ls1031/Claude-ESP32-PCB-Demo/hardware/docs/schematic.pdf

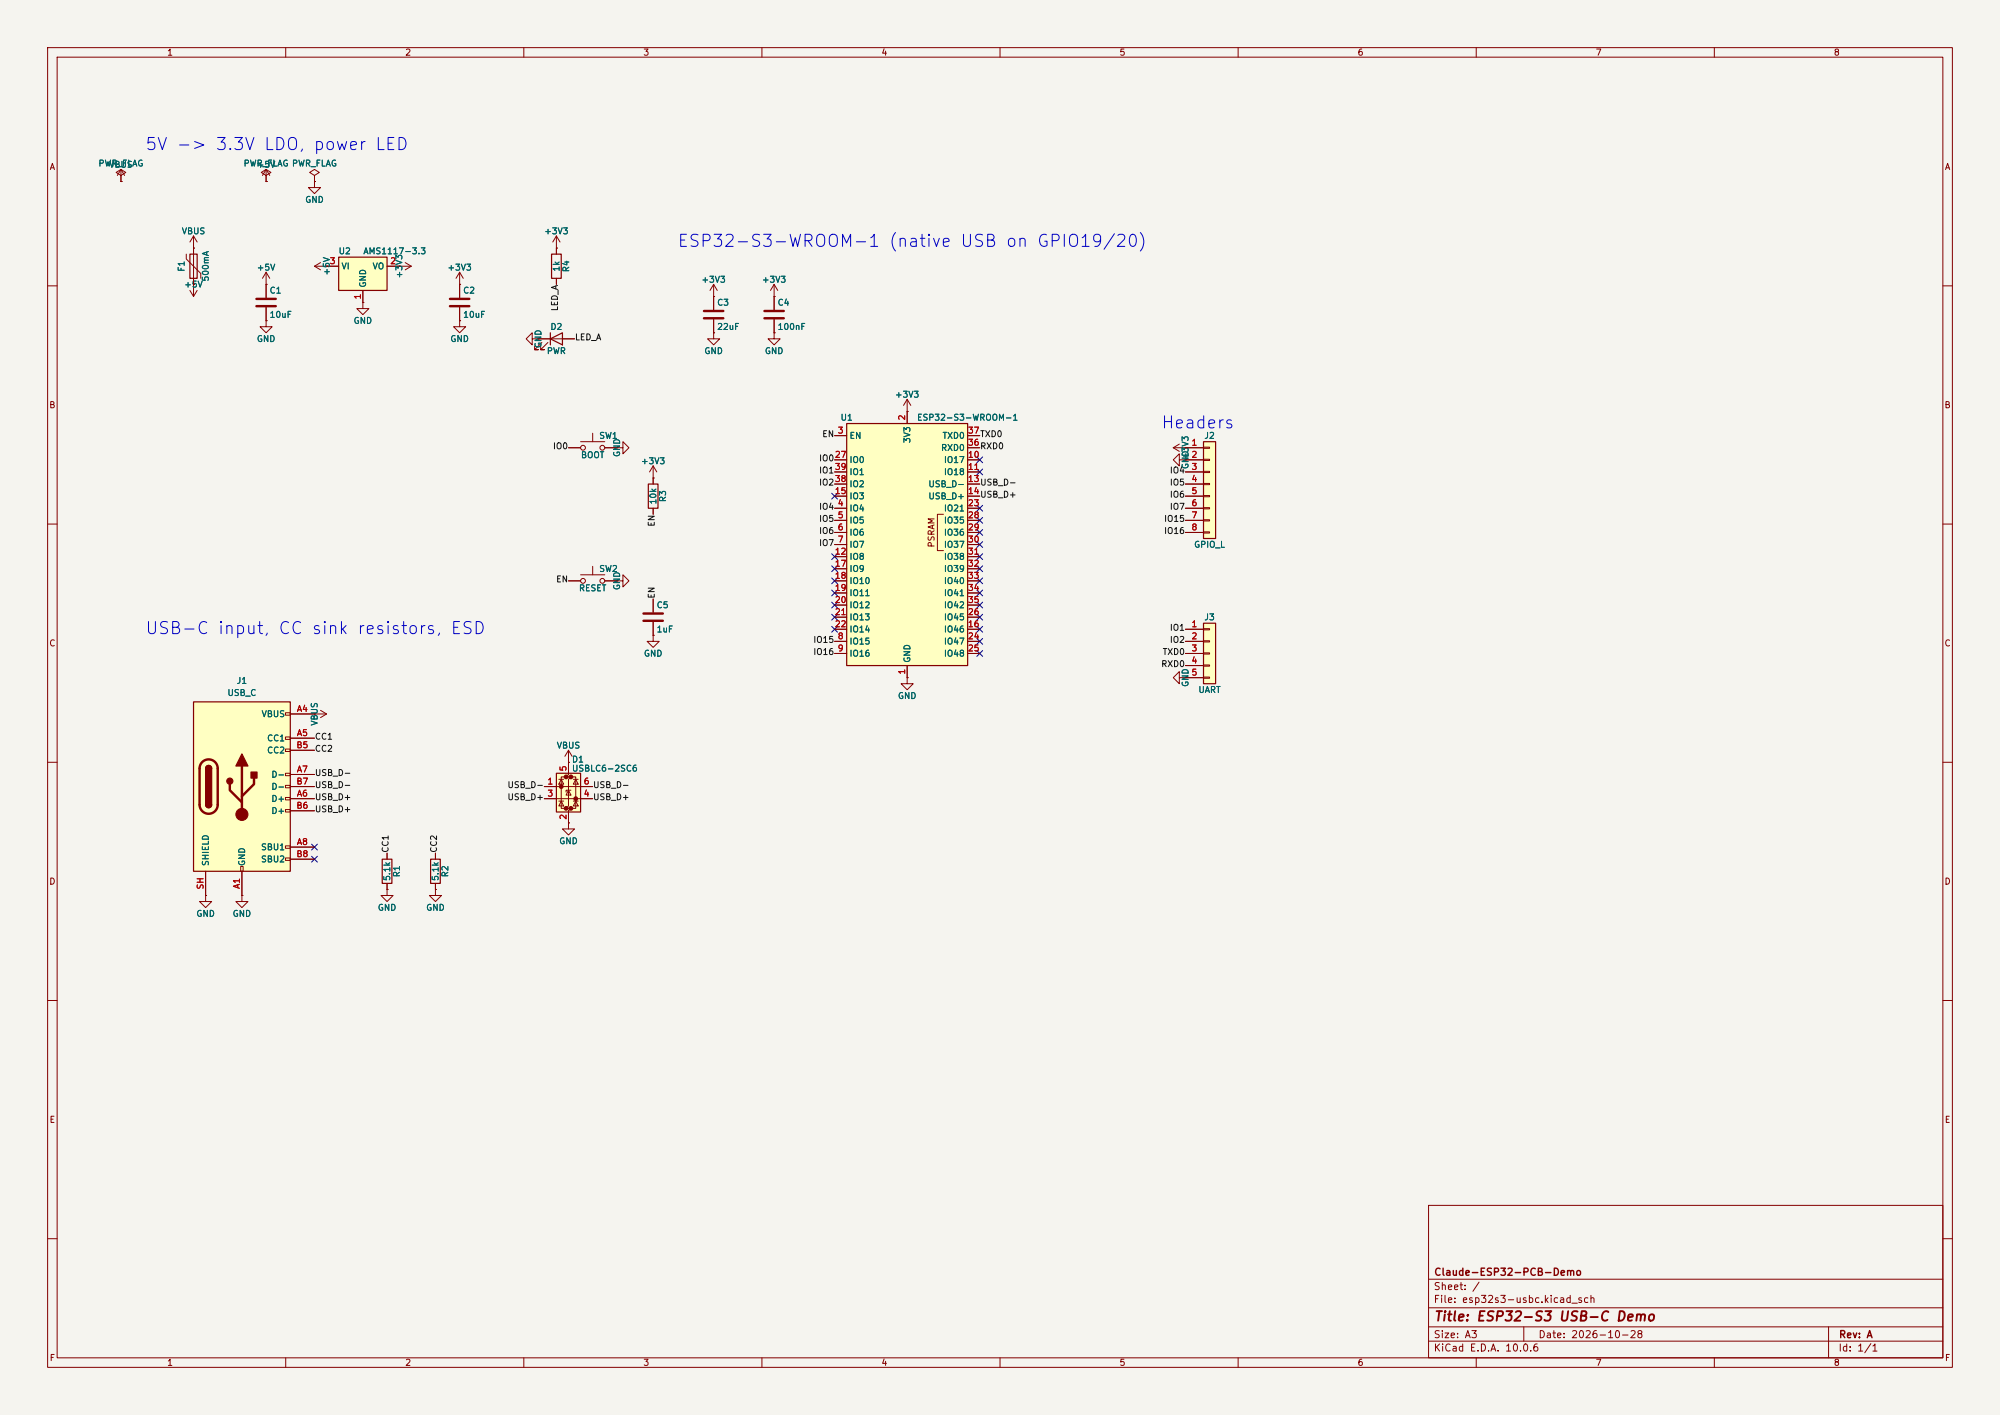
[picture p3: page 1]

ESP32-S3-WROOM-1 (native USB on GPIO19/20)

USB-C input, CC sink resistors, ESD

Size: A3 | Rev: A | F Date: 2026-10-28
KiCad E.D.A. 10.0.6 | Id: 1/1
