ls1031/Claude-ESP32-PCB-Demo/hardware/esp32s3-usbc/esp32s3-usbc.kicad_pcb

## KiCad design hardware/esp32s3-usbc/esp32s3-usbc.kicad_pcb (2026-10-29)

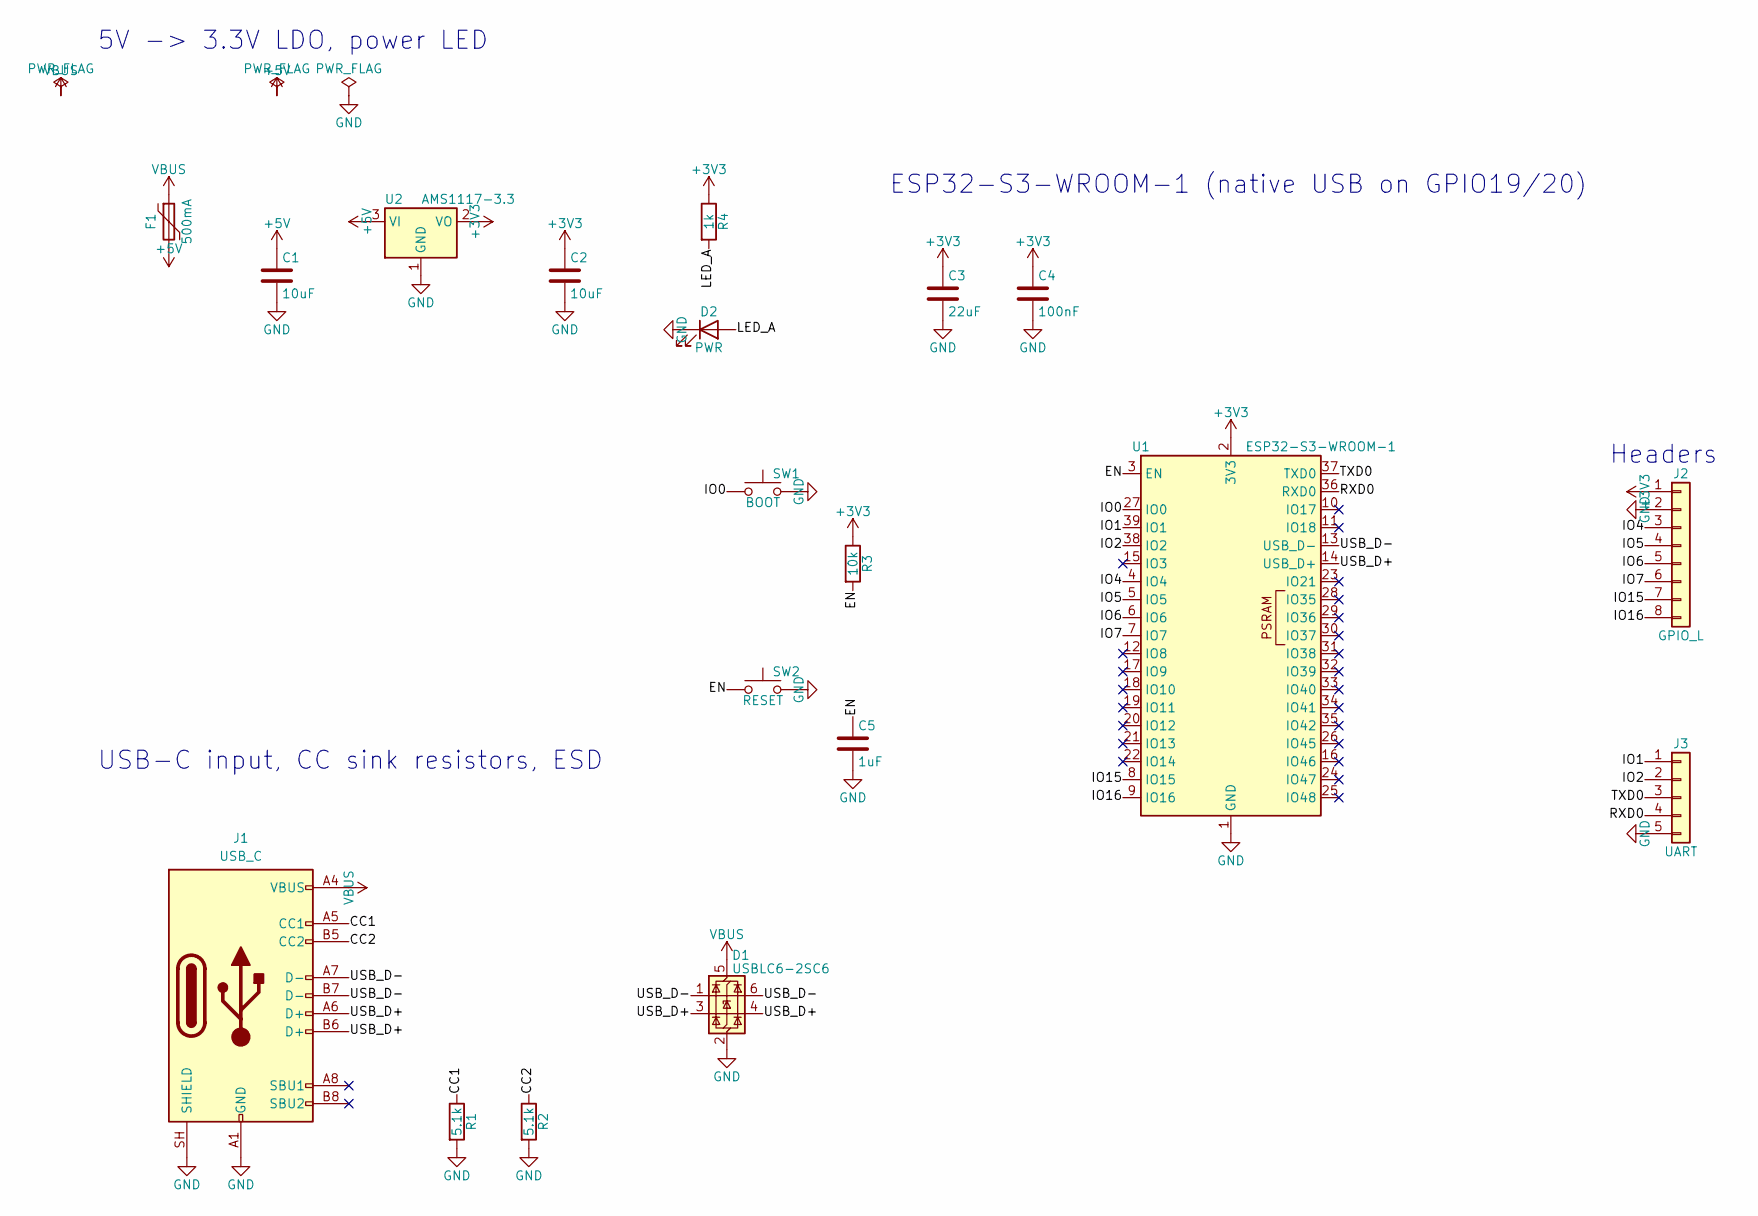
[picture p4: schematic esp32s3-usbc.kicad_sch, ESP32-S3 USB-C Demo]

Parts:
C1, C2: 10uF; C_0805_2012Metric
C3: 22uF; C_0805_2012Metric
C4: 100nF; C_0402_1005Metric
C5: 1uF; C_0603_1608Metric
D1: USBLC6-2SC6; SOT-23-6
D2: PWR; LED_0603_1608Metric
F1: 500mA; Fuse_1206_3216Metric
J1: USB_C; USB_C_Receptacle_GCT_USB4105-xx-A_16P_TopMnt_Horizontal
J2: GPIO_L; PinHeader_1x08_P2.54mm_Vertical
J3: UART; PinHeader_1x05_P2.54mm_Vertical
R1, R2: 5.1k; R_0603_1608Metric
R3: 10k; R_0603_1608Metric
R4: 1k; R_0603_1608Metric
SW1: BOOT; SW_SPST_PTS645Sx43SMTR92
SW2: RESET; SW_SPST_PTS645Sx43SMTR92
U1: ESP32-S3-WROOM-1
U2: AMS1117-3.3; SOT-223-3_TabPin2

Connections:
+3V3: C2.1, C3.1, C4.1, J2.1, R3.1, R4.1, U1.2 (3V3), U2.2 (VO)
+5V: C1.1, F1.2, U2.3 (VI)
/CC1: J1.A5 (CC1), R1.1
/CC2: J1.B5 (CC2), R2.1
/EN: C5.1, R3.2, SW2.1, U1.3 (EN)
/IO0: SW1.1, U1.27 (IO0)
/IO1: J3.1, U1.39 (IO1)
/IO2: J3.2, U1.38 (IO2)
/IO4: J2.3, U1.4 (IO4)
/IO5: J2.4, U1.5 (IO5)
/IO6: J2.5, U1.6 (IO6)
/IO7: J2.6, U1.7 (IO7)
/IO15: J2.7, U1.8 (IO15)
/IO16: J2.8, U1.9 (IO16)
/LED_A: D2.2 (A), R4.2
/RXD0: J3.4, U1.36 (RXD0)
/TXD0: J3.3, U1.37 (TXD0)
/USB_D+: D1.3 (I/O2), D1.4 (I/O2), J1.A6 (D+), J1.B6 (D+), U1.14 (USB_D+)
/USB_D-: D1.1 (I/O1), D1.6 (I/O1), J1.A7 (D-), J1.B7 (D-), U1.13 (USB_D-)
GND: C1.2, C2.2, C3.2, C4.2, C5.2, D1.2 (GND), D2.1 (K), J1.A1 (GND), J1.A12 (GND), J1.B1 (GND), J1.B12 (GND), J1.SH (SHIELD), J2.2, J3.5, R1.2, R2.2, SW1.2, SW2.2, U1.1 (GND), U1.40 (GND), U1.41 (GND), U2.1 (GND)
VBUS: D1.5 (VBUS), F1.1, J1.A4 (VBUS), J1.A9 (VBUS), J1.B4 (VBUS), J1.B9 (VBUS)

Notes on the sheet:
USB-C input, CC sink resistors, ESD
5V -> 3.3V LDO, power LED
ESP32-S3-WROOM-1 (native USB on GPIO19/20)
Headers

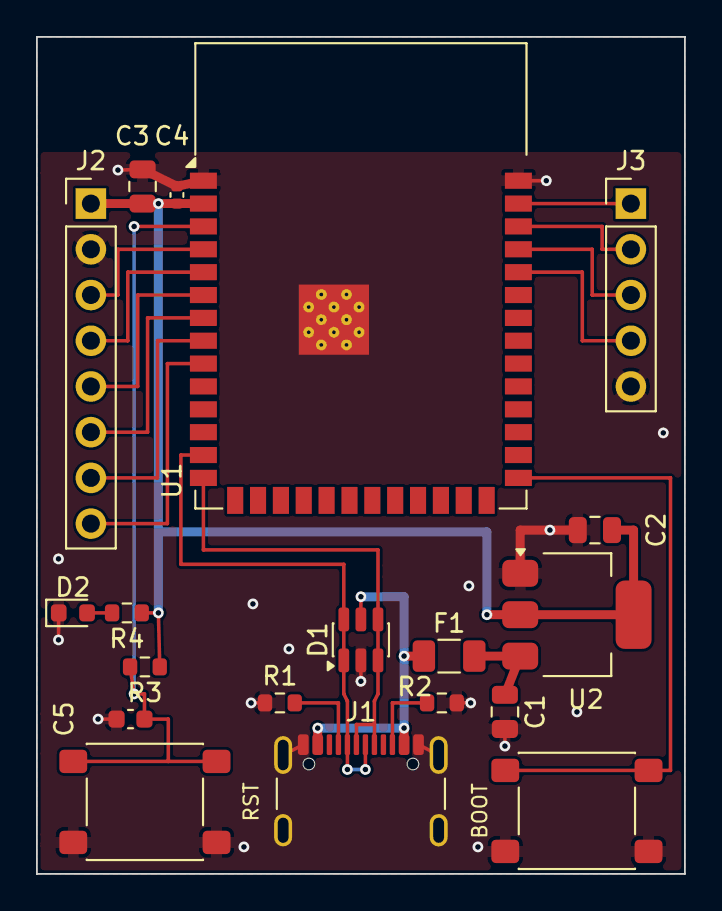
[picture p5: board esp32s3-usbc.kicad_pcb from above]

Board: 2 copper layers, 36.0 x 46.5 mm, 19 parts (0 on the bottom side), 21 nets.
