ls1031/Claude-ESP32-PCB-Demo/hardware/scripts/sexpr.py

"""Minimal S-expression reader/writer for KiCad files."""
import re

_TOKEN = re.compile(r'\s*(?:(\()|(\))|"((?:[^"\\]|\\.)*)"|([^\s()"]+))', re.S)


class Sym(str):
    """Unquoted atom (keyword / number)."""


def parse(text):
    stack, cur = [], []
    pos = 0
    while True:
        m = _TOKEN.match(text, pos)
        if not m or m.end() == pos:
            break
        pos = m.end()
        if m.group(1):
            stack.append(cur)
            cur = []
        elif m.group(2):
            done = cur
            cur = stack.pop()
            cur.append(done)
        elif m.group(3) is not None:
            cur.append(m.group(3).replace('\\"', '"').replace("\\\\", "\\"))
        else:
            cur.append(Sym(m.group(4)))
    return cur[0]


def _atom(a):
    if isinstance(a, Sym):
        return str(a)
    if isinstance(a, bool):
        return "yes" if a else "no"
    if isinstance(a, (int, float)):
        s = f"{a:.4f}".rstrip("0").rstrip(".")
        return "0" if s in ("-0", "") else s
    return '"' + str(a).replace("\\", "\\\\").replace('"', '\\"') + '"'


def dump(node, indent=0):
    if not isinstance(node, list):
        return _atom(node)
    simple = all(not isinstance(x, list) for x in node)
    if simple:
        return "(" + " ".join(_atom(x) for x in node) + ")"
    pad = "\t" * (indent + 1)
    parts = []
    head = []
    for x in node:
        if isinstance(x, list):
            break
        head.append(_atom(x))
    out = "(" + " ".join(head)
    for x in node[len(head):]:
        out += "\n" + pad + dump(x, indent + 1)
    return out + "\n" + "\t" * indent + ")"


def find(node, key):
    for x in node:
        if isinstance(x, list) and x and x[0] == key:
            return x
    return None


def find_all(node, key):
    return [x for x in node if isinstance(x, list) and x and x[0] == key]
